mikeysklar/eink-audio-player/docs/media/anatomy/eink-audio-player.gif

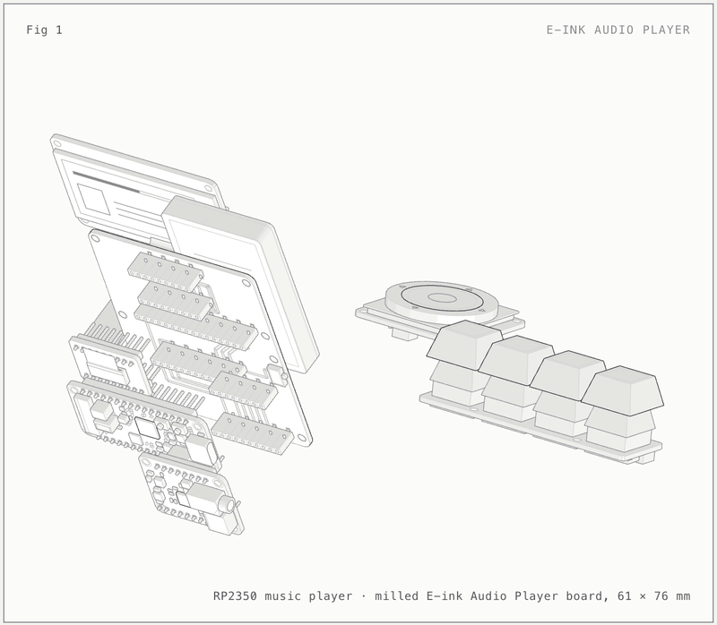
docs/media/anatomy/eink-audio-player.gif
