mikeysklar/eink-audio-player/docs/media/blender/board-hero.png

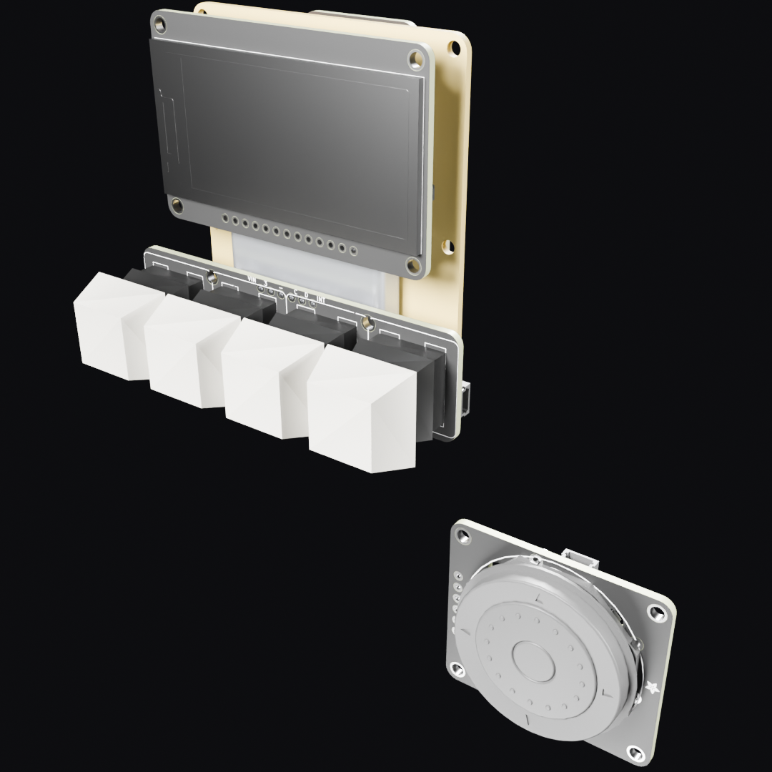
docs/media/blender/board-hero.png
