mikeysklar/eink-audio-player/docs/media/blender/exploded.png

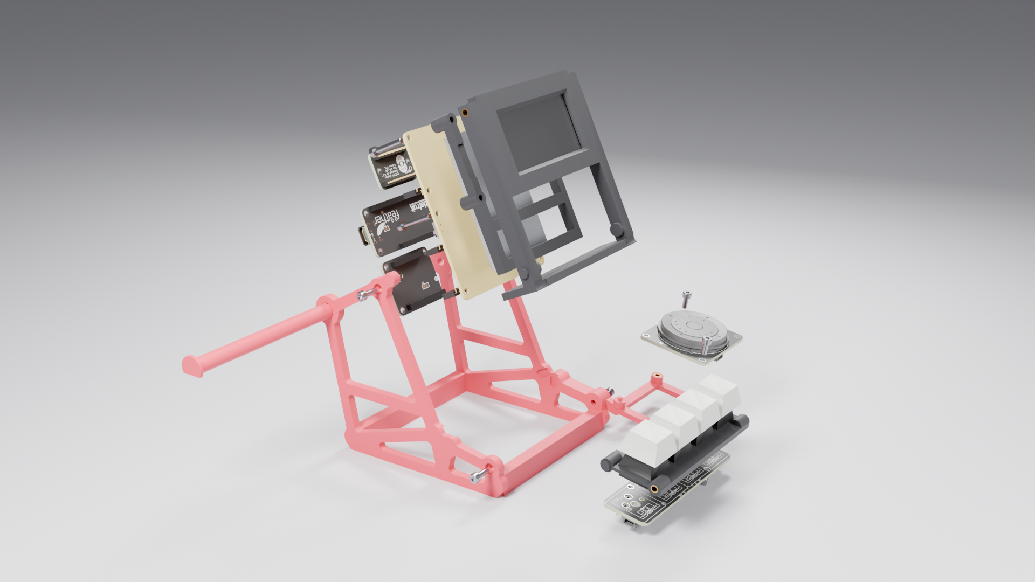
docs/media/blender/exploded.png
