mikeysklar/eink-audio-player/docs/media/blender/hero.png

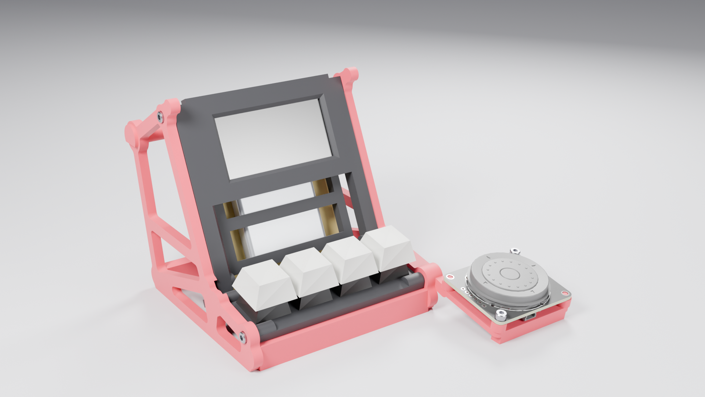
docs/media/blender/hero.png
