mikeysklar/eink-audio-player/docs/media/kicad/pcb-3d-top.png

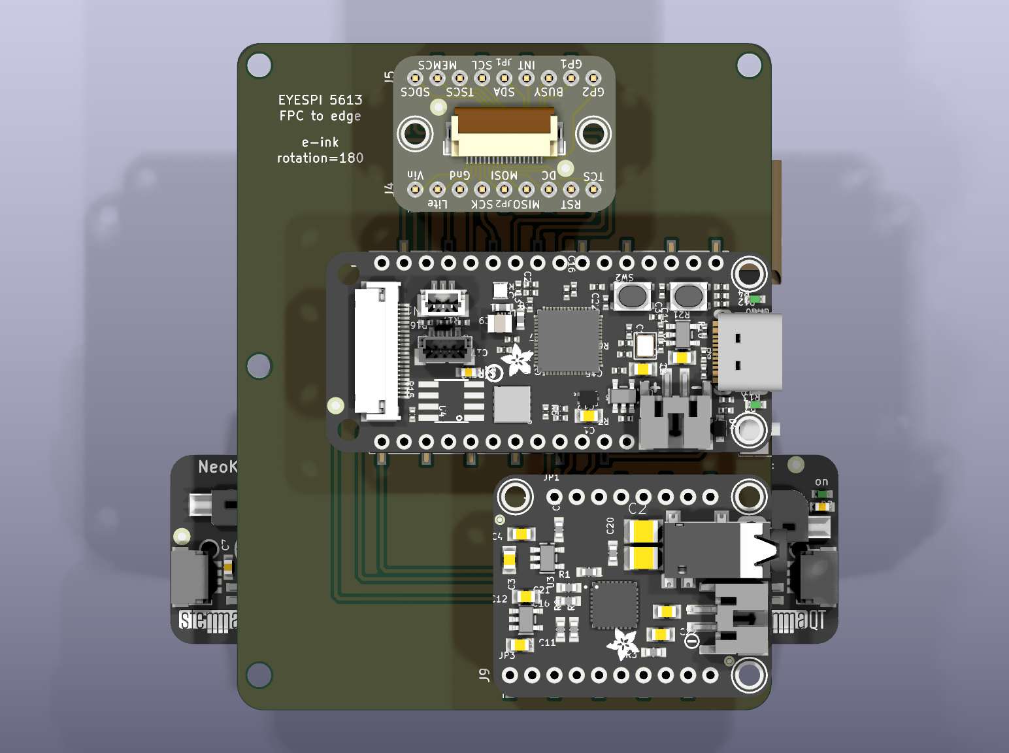
docs/media/kicad/pcb-3d-top.png
