mikeysklar/eink-audio-player/docs/media/menus/1-albums.png

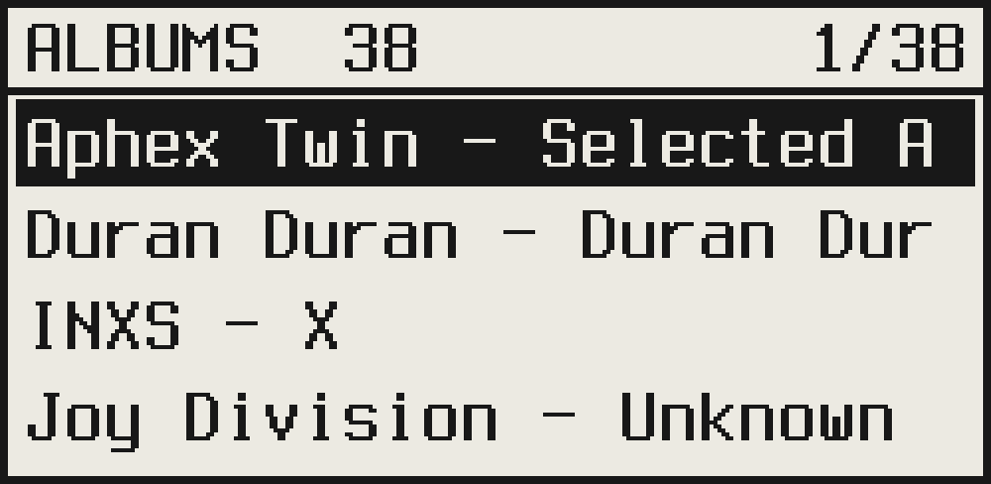
docs/media/menus/1-albums.png
