mikeysklar/eink-audio-player/docs/media/menus/2-albums-scrolled.png

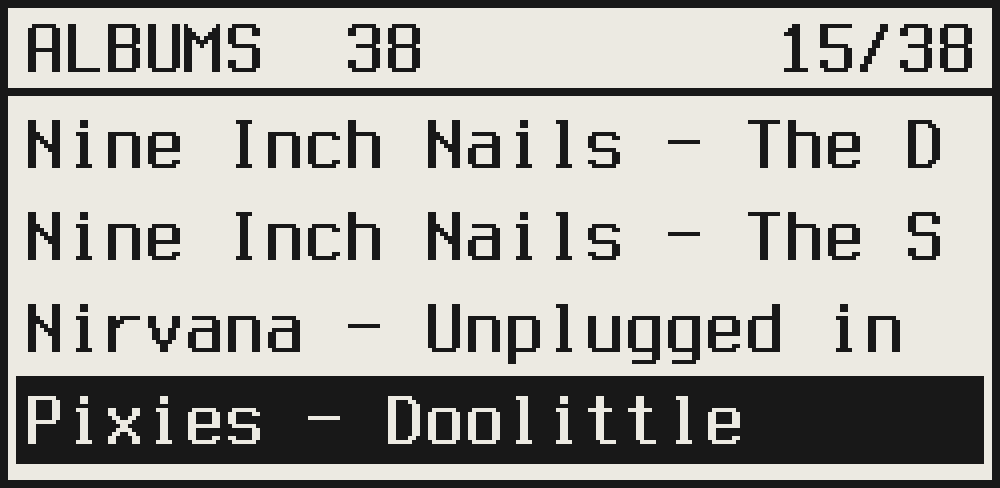
docs/media/menus/2-albums-scrolled.png
