mikeysklar/eink-audio-player/docs/media/menus/3-tracks.png

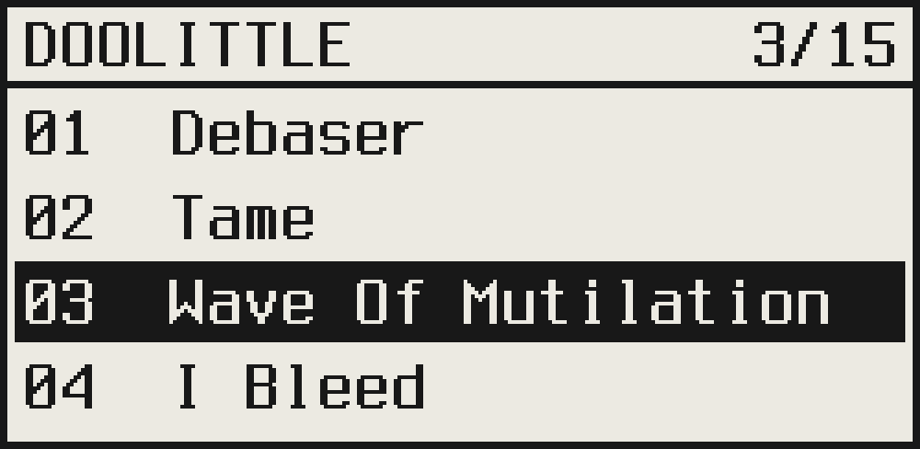
docs/media/menus/3-tracks.png
