mikeysklar/eink-audio-player/docs/media/menus/4-now-playing.png

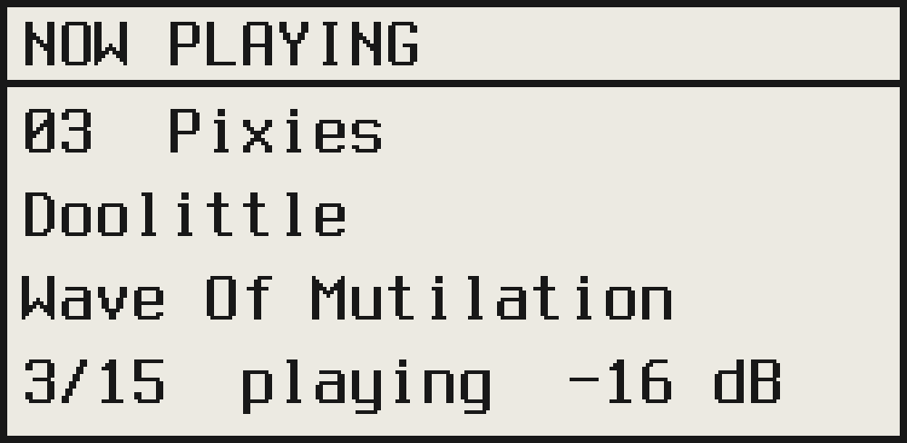
docs/media/menus/4-now-playing.png
