mikeysklar/eink-audio-player/docs/media/menus/5-now-paused.png

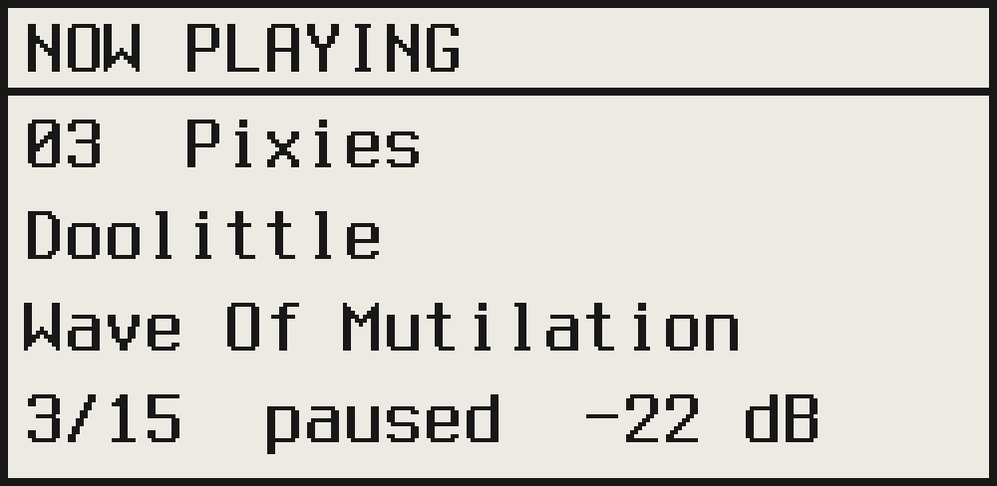
docs/media/menus/5-now-paused.png
