mikeysklar/eink-audio-player/docs/media/menus/6-search-empty.png

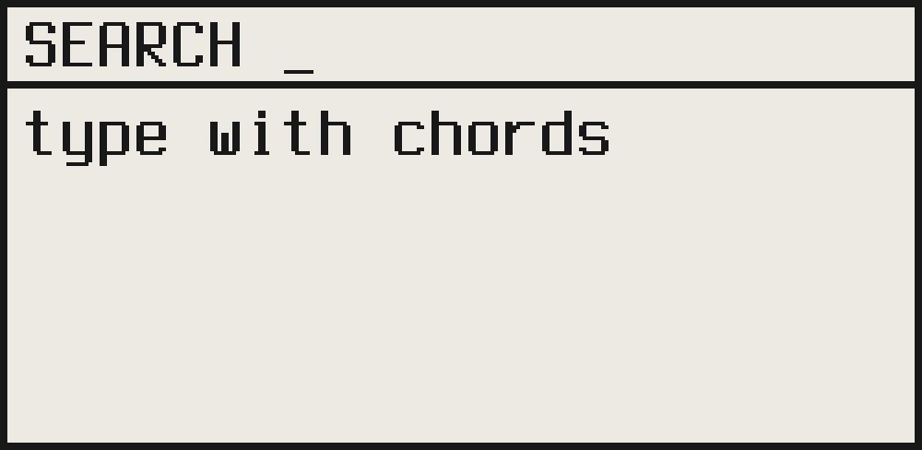
docs/media/menus/6-search-empty.png
