mikeysklar/eink-audio-player/docs/media/menus/7-search-sh.png

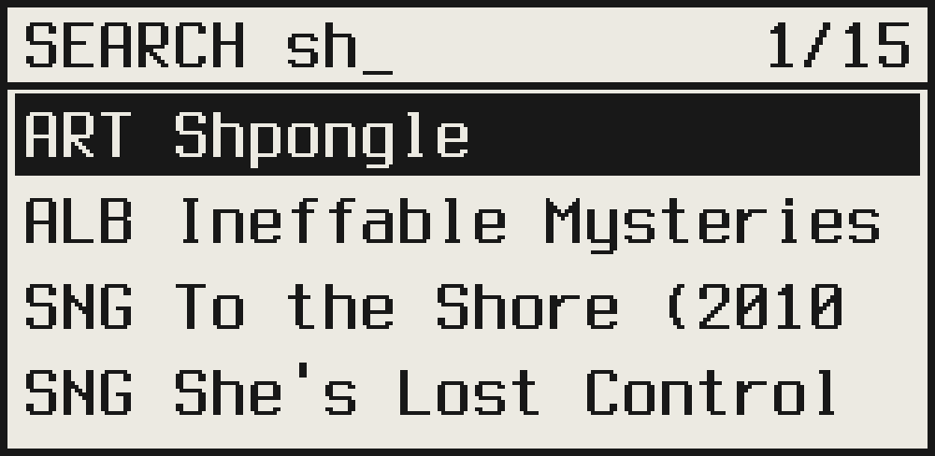
docs/media/menus/7-search-sh.png
