mikeysklar/eink-audio-player/docs/media/menus/8-search-shad.png

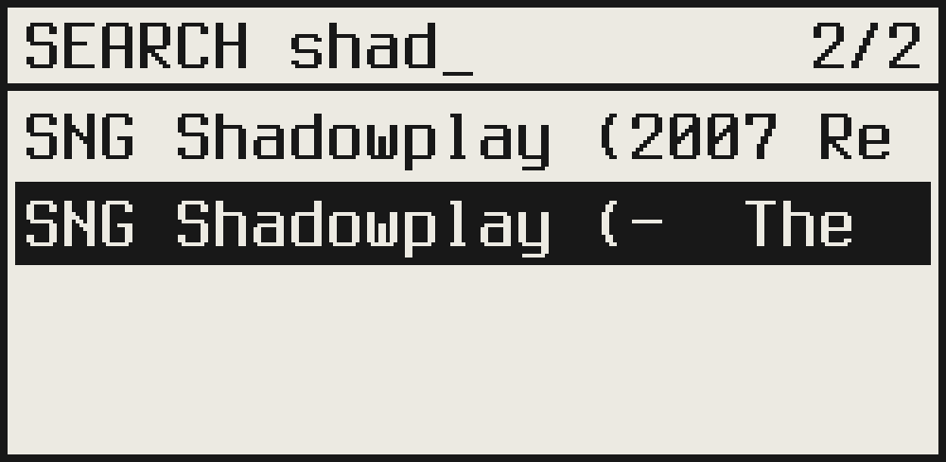
docs/media/menus/8-search-shad.png
