mikeysklar/eink-audio-player/docs/media/menus/9-search-rem.png

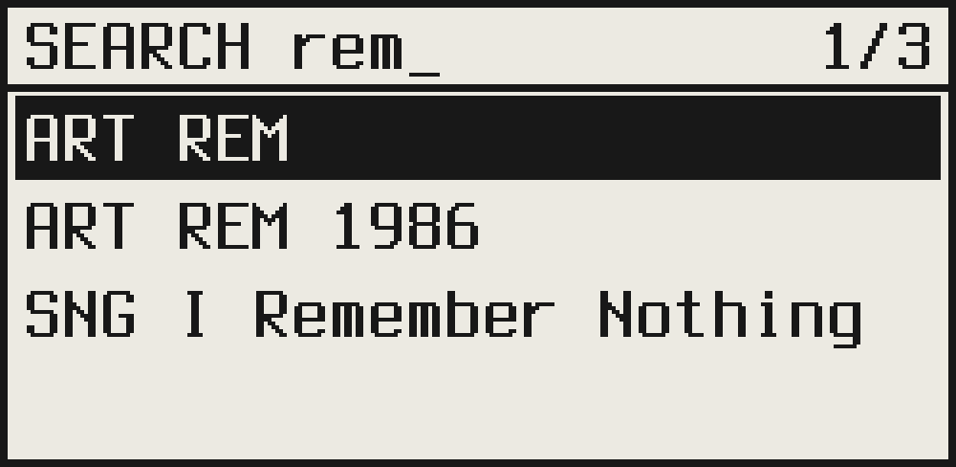
docs/media/menus/9-search-rem.png
