mikeysklar/eink-audio-player/docs/media/menus/10-artist.png

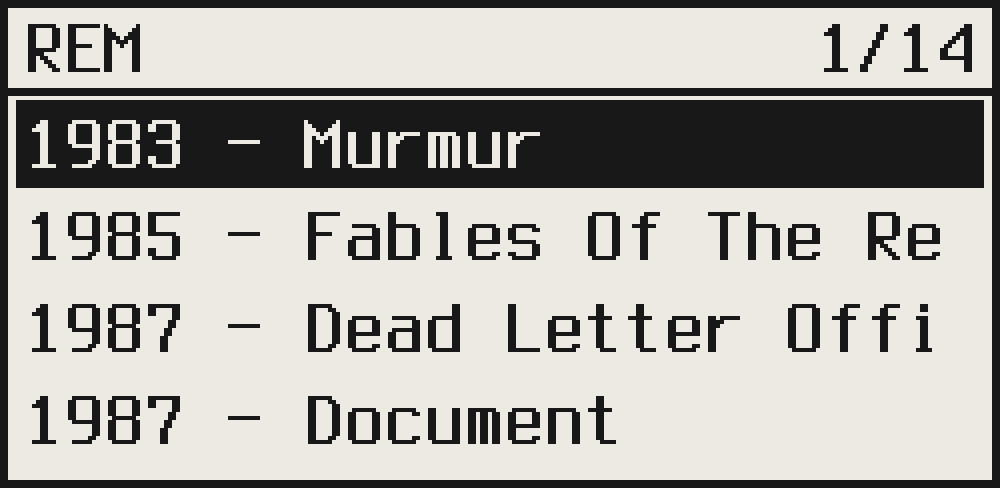
docs/media/menus/10-artist.png
