mikeysklar/eink-audio-player/enclosure/frisson.FCStd

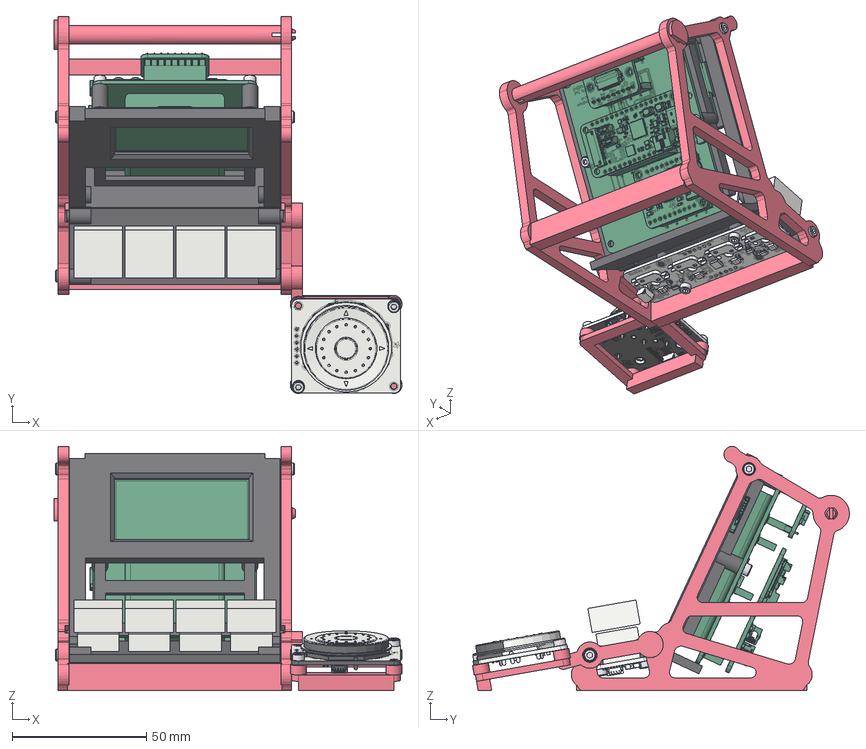
[picture p25: CAD file, 2026-10-26]
enclosure/frisson.FCStd
129.6 x 140.5 x 91.0 mm
chassis
bezel
deck
cradle
handle
board_stack
neokey_keys
ano
hardware
