mikeysklar/eink-audio-player/enclosure/step/hardware.step

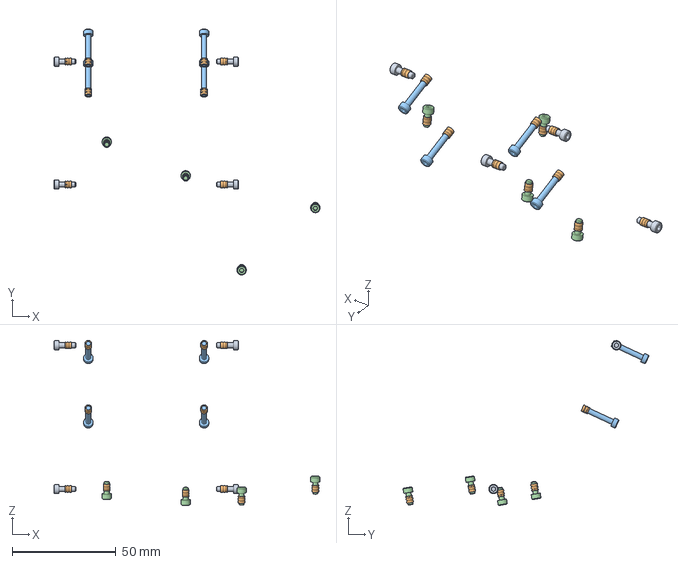
[picture p26: CAD file, 2026-10-24]
enclosure/step/hardware.step
128.3 x 118.7 x 79.7 mm
