mikeysklar/eink-audio-player/kicad/3d/5740 ANO Rotary Encoder QT.step

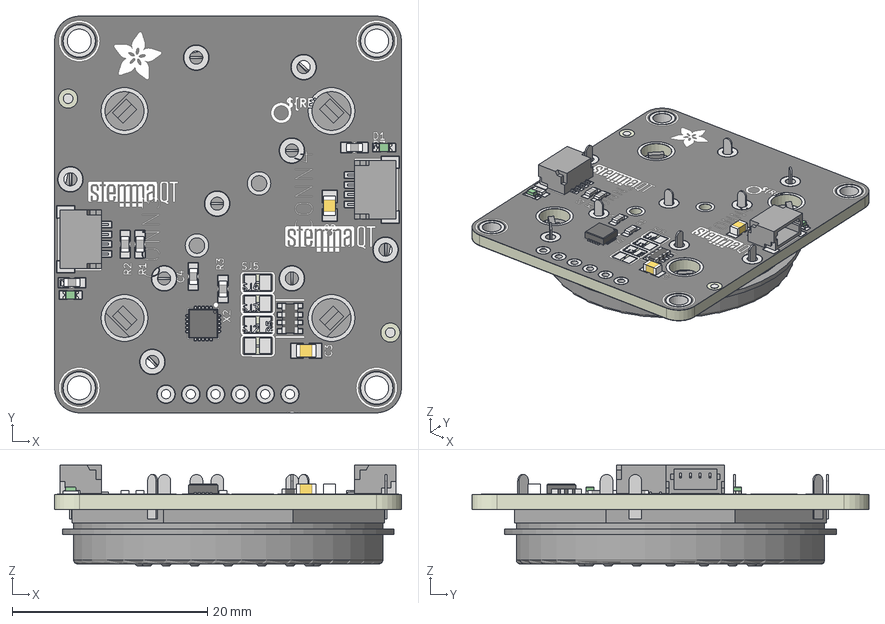
[picture p27: CAD file, 2026-10-24]
kicad/3d/5740 ANO Rotary Encoder QT.step
35.6 x 40.6 x 10.3 mm
0805-NO x 2
0603-NO x 6
JST_SH4 x 2
CHIPLED_0603_NOOUTLINE x 2
ENCODER_ANO
QFN20_3MM
RESPACK_4X0603
ano_pad
ano_silkscreen x 2
ano_soldermask x 2
ano_PCB
