mikeysklar/eink-audio-player/enclosure/step/deck.step

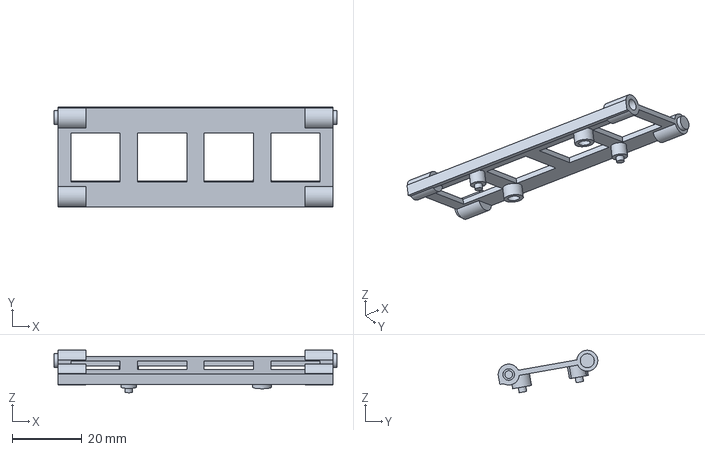
[picture p28: CAD file, 2026-10-24]
enclosure/step/deck.step
80.9 x 28.6 x 12.2 mm
