mikeysklar/eink-audio-player/kicad/3d/6366 2.13in Tri-Color eInk.step

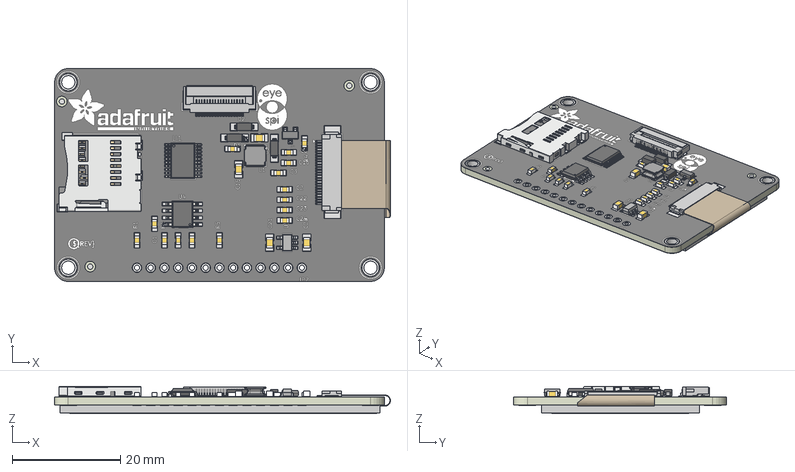
[picture p29: CAD file, 2026-10-24]
kicad/3d/6366 2.13in Tri-Color eInk.step
62.1 x 39.4 x 5.00 mm
0805-NO x 4
0603-NO x 15
SOT23-5
SOIC8_150MIL
EINK_213IN_104X212
SOD-123 x 3
INDUCTOR_4X4MM_NR401
SOT23-3
MICROSD
TSSOP20
EYE_SPI_DISPLAY_BOTCONTACT
FPC-connector-24pin v3
eink_pad
eink_silkscreen x 2
eink_soldermask x 2
eink_PCB
