mikeysklar/eink-audio-player/enclosure/step/eink-audio-player-stand.step

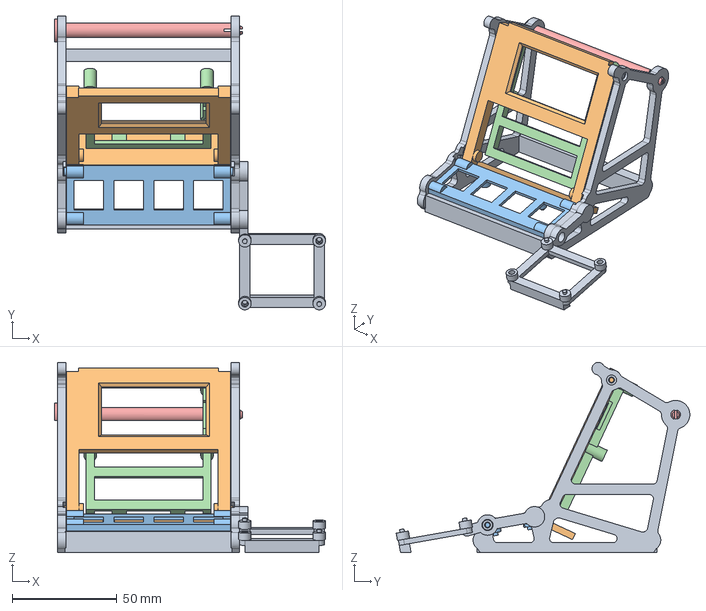
[picture p30: CAD file, 2026-10-24]
enclosure/step/eink-audio-player-stand.step
129.6 x 140.5 x 91.0 mm
