mikeysklar/eink-audio-player/kicad/3d/5613 EYESPI Breakout.step

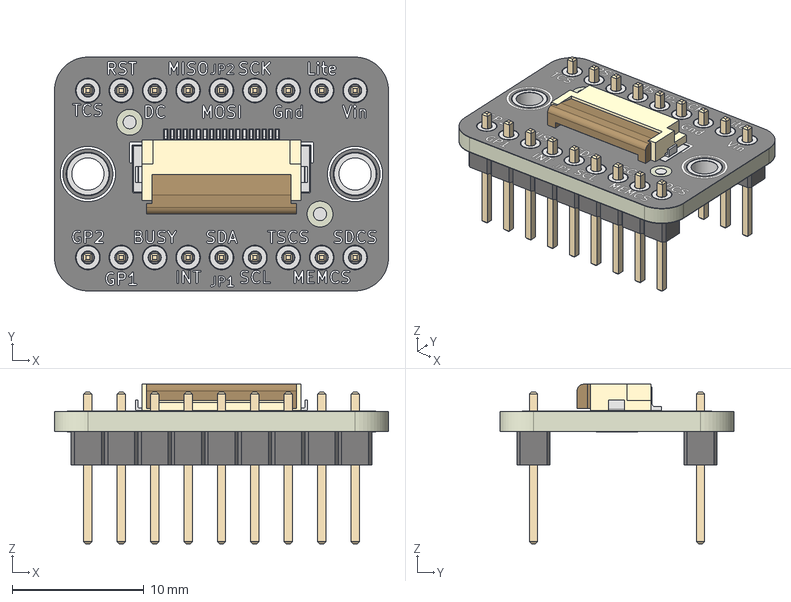
[picture p31: CAD file, 2026-10-24]
kicad/3d/5613 EYESPI Breakout.step
25.4 x 17.8 x 12.1 mm
PinHeader_1x09_P254mm_Vertical x 2
lock
pins
eyespi_copper
eyespi_pad
eyespi_silkscreen x 2
eyespi_soldermask x 2
eyespi_PCB
