mikeysklar/eink-audio-player/enclosure/step/chassis.step

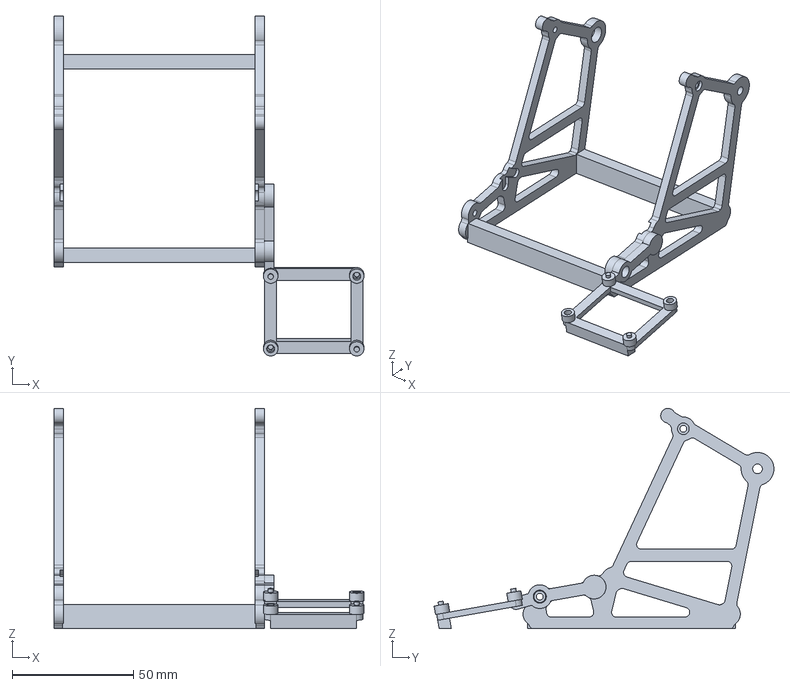
[picture p32: CAD file, 2026-10-24]
enclosure/step/chassis.step
128.1 x 140.5 x 91.0 mm
