mikeysklar/eink-audio-player/kicad/3d/4980 NeoKey 1x4 QT.step

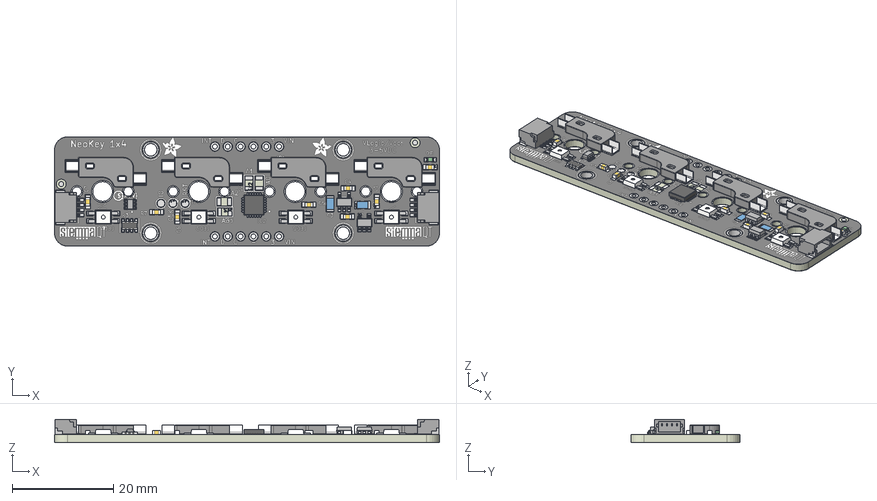
[picture p33: CAD file, 2026-10-24]
kicad/3d/4980 NeoKey 1x4 QT.step
76.2 x 21.6 x 4.61 mm
KAILH_SOCKET x 4
NEO3535_REVERSE x 4
0603-NO x 8
0805-NO x 2
SOT23-5
RESPACK_4X0603
SOT363
JST_SH4 x 2
CHIPLED_0603_NOOUTLINE
QFN24_4MM
SOT23-5 (1)
neokey_pad
neokey_silkscreen x 2
neokey_soldermask x 2
neokey_PCB
