mikeysklar/eink-audio-player/enclosure/step/bezel.step

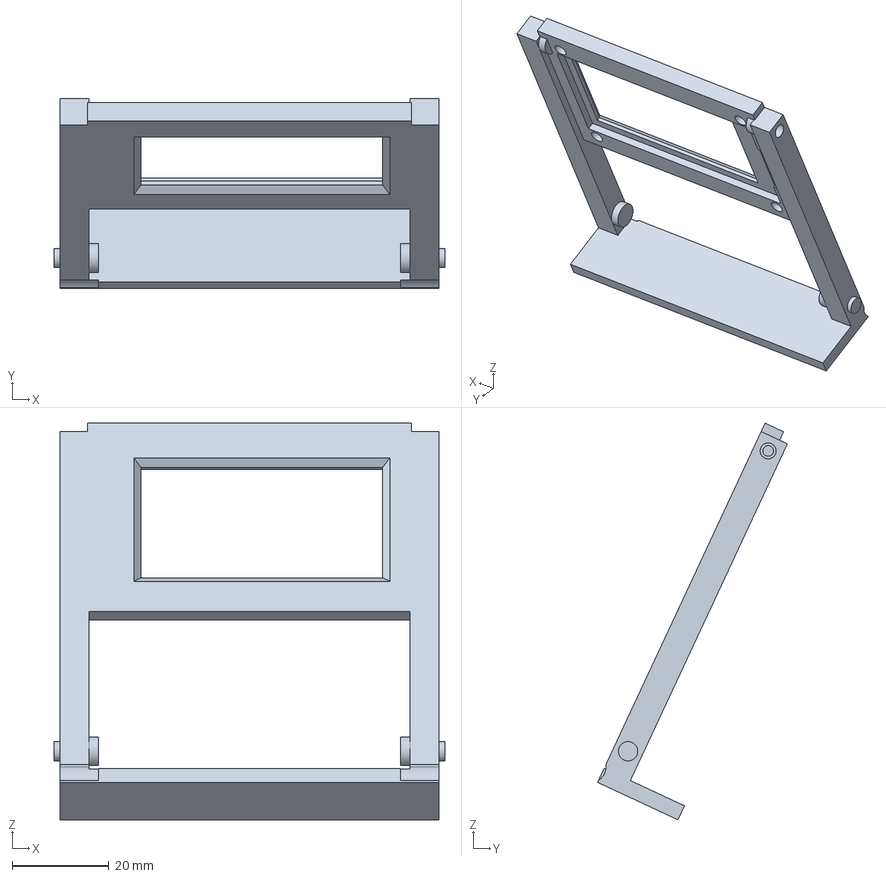
[picture p34: CAD file, 2026-10-24]
enclosure/step/bezel.step
80.9 x 39.3 x 82.1 mm
