mikeysklar/eink-audio-player/kicad/3d/6309 TLV320DAC3100 I2S DAC.step

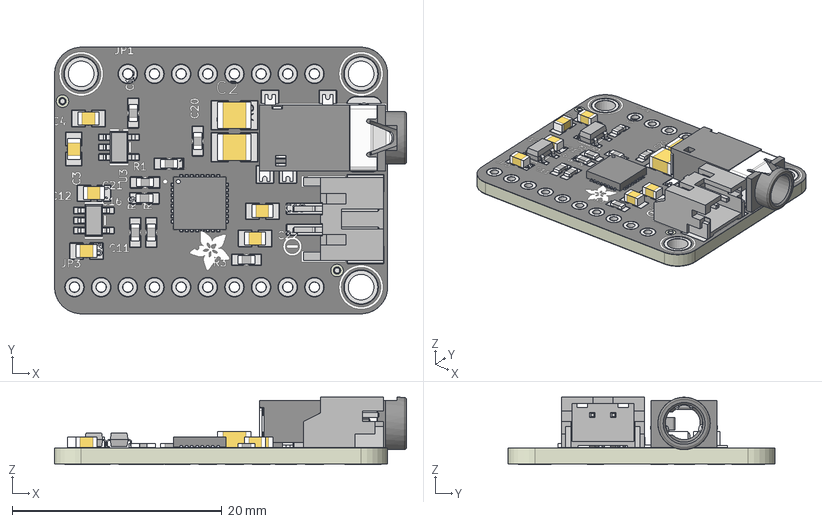
[picture p35: CAD file, 2026-10-24]
kicad/3d/6309 TLV320DAC3100 I2S DAC.step
33.5 x 25.4 x 6.45 mm
SOT23-5 x 2
0805-NO x 6
0603-NO x 8
PJ-332A
TLV320DAC3100
C1210 x 2
JSTPH2
tlv_pad
tlv_silkscreen x 2
tlv_soldermask x 2
tlv_PCB
