mikeysklar/eink-audio-player/enclosure/step/cradle.step

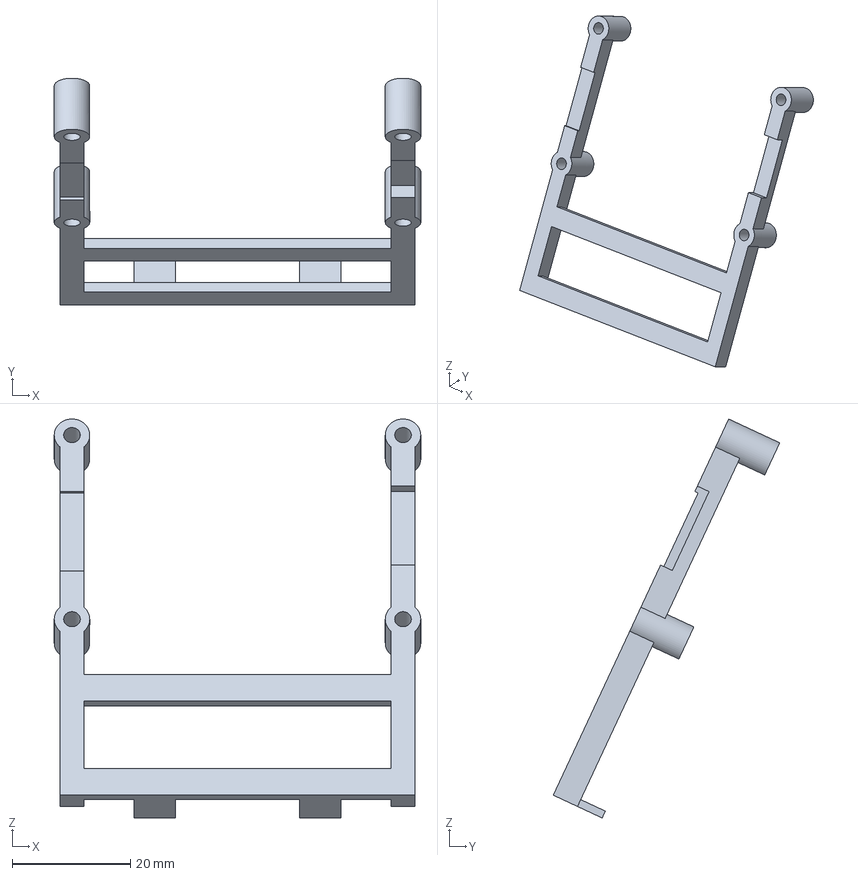
[picture p36: CAD file, 2026-10-24]
enclosure/step/cradle.step
61.9 x 38.2 x 67.4 mm
