mikeysklar/eink-audio-player/kicad/3d/6000 Feather RP2350.step

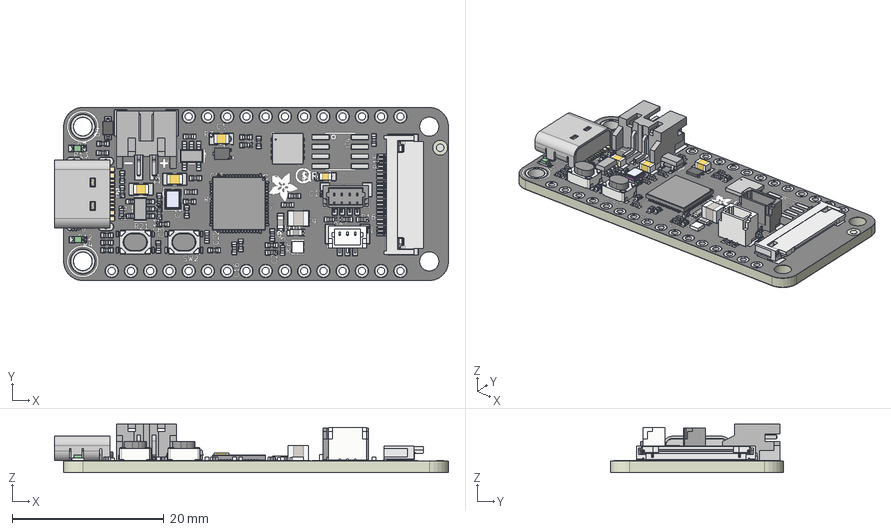
[picture p37: CAD file, 2026-10-24]
kicad/3d/6000 Feather RP2350.step
52.0 x 22.9 x 6.45 mm
0805-NO x 3
CHIPLED_0603_NOOUTLINE x 2
_0402NO x 34
BTN_RKB2_4.6X2.8 x 2
SOT23-5
JSTPH2_BATT
SOT23-5 (1)
0603-NO
SK6805_1515
USON8_4X4
SOD-323F
DFN2015-3
USB_C_CUSB31-CFM2AX-01-X
CRYSTAL_2.5X2
_0603MP x 2
QFN60_7MM_REDUCEDEPAD
INDUCTOR_1007
FPC_22PIN
JST_SH4_RA
JST_SH3_RA
feather_pad
feather_silkscreen x 2
feather_soldermask x 2
feather_PCB
