mikeysklar/eink-audio-player/enclosure/step/handle.step

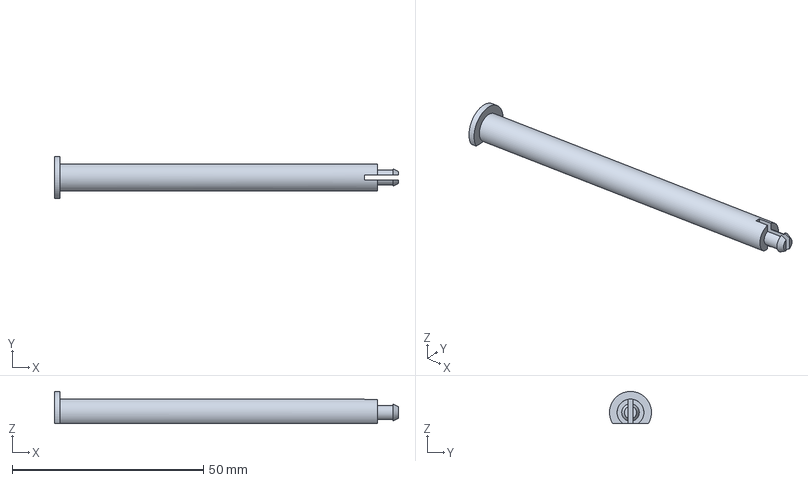
[picture p38: CAD file, 2026-10-24]
enclosure/step/handle.step
90.0 x 11.0 x 8.40 mm
