mikeysklar/eink-audio-player/kicad/3d/LiPo 2750 PLACEHOLDER.step

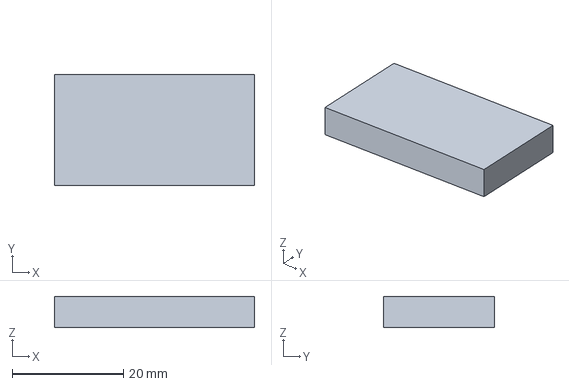
[picture p39: CAD file, 2026-10-23]
kicad/3d/LiPo 2750 PLACEHOLDER.step
36.0 x 20.0 x 5.60 mm
