mikeysklar/eink-audio-player/enclosure/step/ano_mount.step

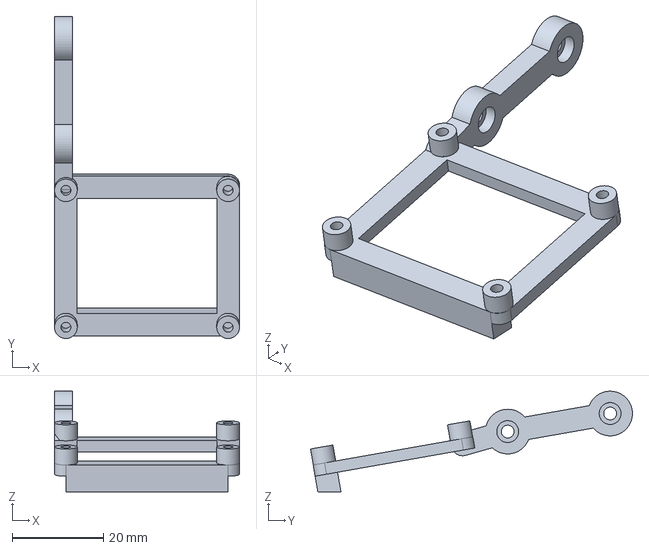
[picture p40: CAD file, 2026-10-24]
enclosure/step/ano_mount.step
40.6 x 70.6 x 22.1 mm
