mikeysklar/eink-audio-player/kicad/3d/LiPo 258 PLACEHOLDER.step

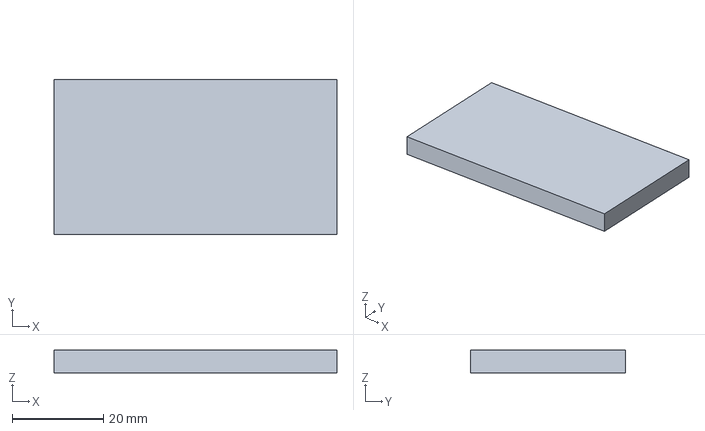
[picture p41: CAD file, 2026-10-23]
kicad/3d/LiPo 258 PLACEHOLDER.step
62.0 x 34.0 x 5.00 mm
