mikeysklar/eink-audio-player/enclosure/step/brace_front.step

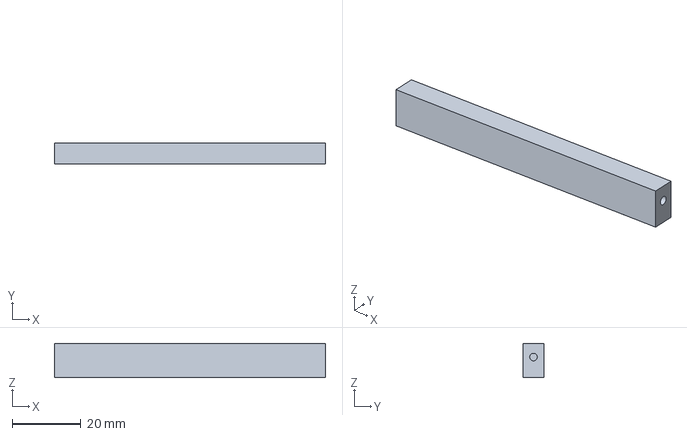
[picture p42: CAD file, 2026-10-23]
enclosure/step/brace_front.step
79.0 x 6.00 x 10.0 mm
