mikeysklar/eink-audio-player/kicad/3d/LiPo 1578 PLACEHOLDER.step

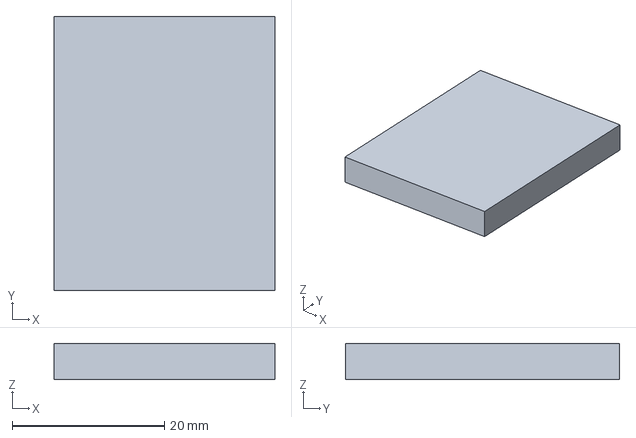
[picture p43: CAD file, 2026-10-23]
kicad/3d/LiPo 1578 PLACEHOLDER.step
29.0 x 36.0 x 4.75 mm
