mikeysklar/eink-audio-player/enclosure/step/cheek_L.step

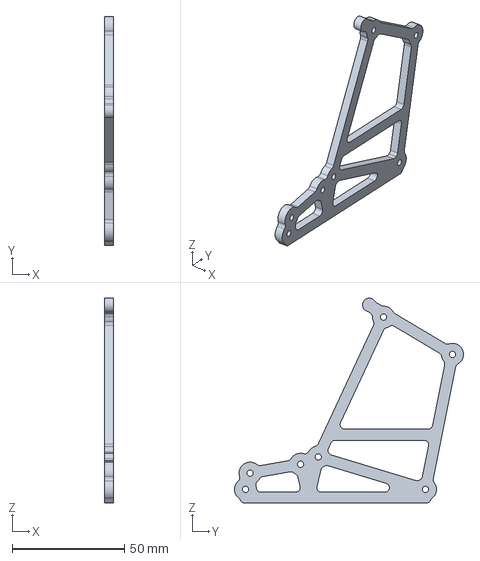
[picture p44: CAD file, 2026-10-23]
enclosure/step/cheek_L.step
4.00 x 101.8 x 91.0 mm
