mikeysklar/eink-audio-player/kicad/3d/slide-switch-smt-mskt-12c03-Part.step

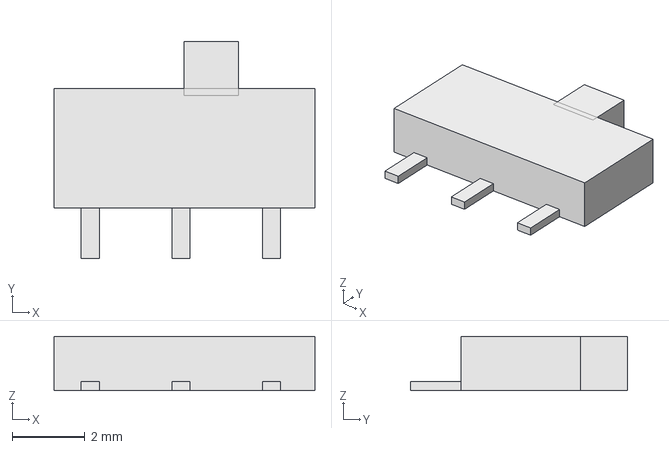
[picture p45: CAD file, 2026-10-23]
kicad/3d/slide-switch-smt-mskt-12c03-Part.step
7.20 x 6.00 x 1.50 mm
