mikeysklar/eink-audio-player/enclosure/step/battery_strap.step

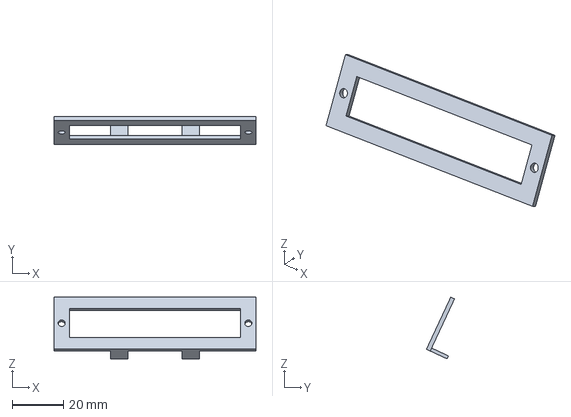
[picture p46: CAD file, 2026-10-23]
enclosure/step/battery_strap.step
79.0 x 11.0 x 24.2 mm
