mikeysklar/eink-audio-player/kicad/3d/4197 eInk 2.13 PLACEHOLDER.step

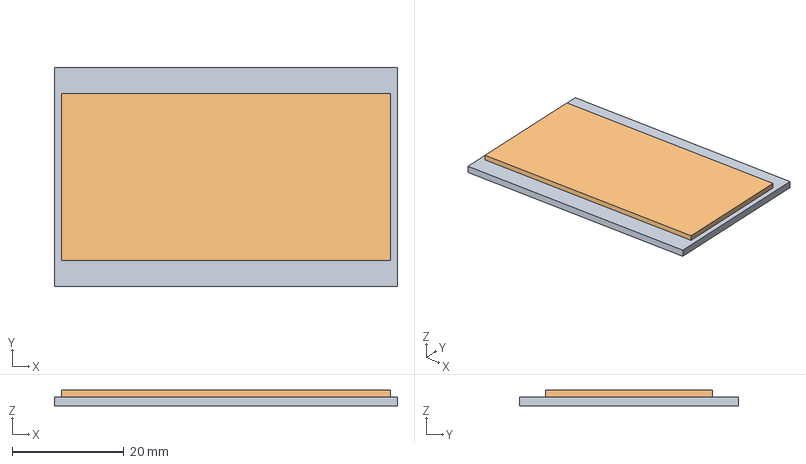
[picture p47: CAD file, 2026-10-23]
kicad/3d/4197 eInk 2.13 PLACEHOLDER.step
61.5 x 39.3 x 2.80 mm
