mikeysklar/eink-audio-player/kicad/3d/LiPo 3898 PLACEHOLDER.step

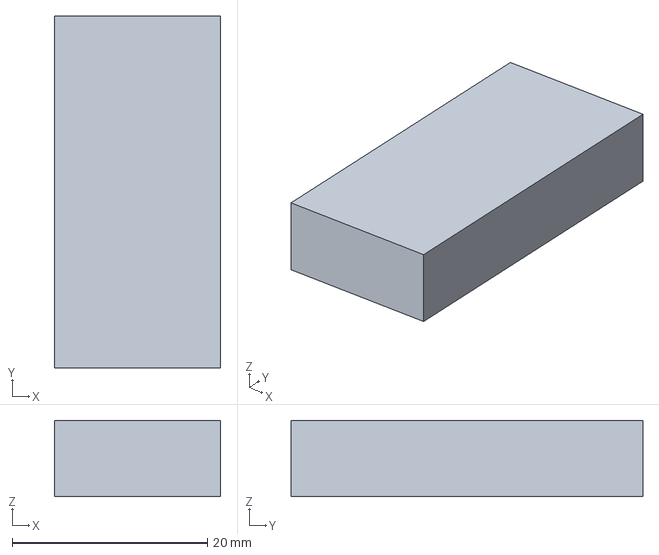
[picture p48: CAD file, 2026-10-23]
kicad/3d/LiPo 3898 PLACEHOLDER.step
17.0 x 36.0 x 7.80 mm
