mikeysklar/eink-audio-player/enclosure/step/brace_top.step

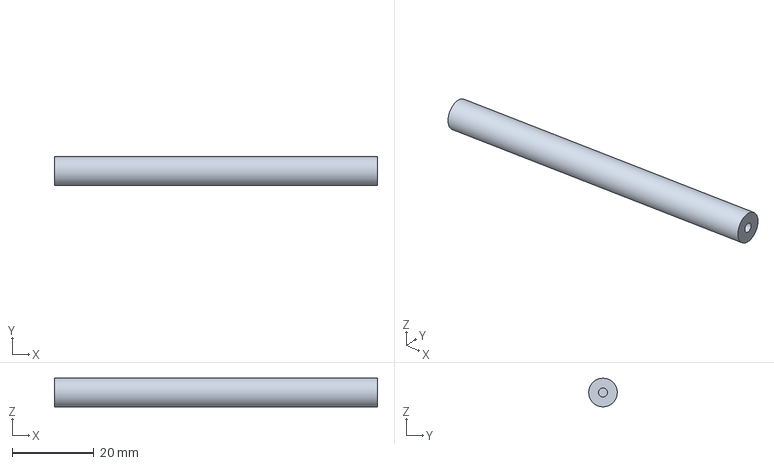
[picture p49: CAD file, 2026-10-23]
enclosure/step/brace_top.step
79.0 x 7.00 x 6.99 mm
