mikeysklar/eink-audio-player/kicad/3d/1028 eInk 2.9 tri-color STAND-IN.step

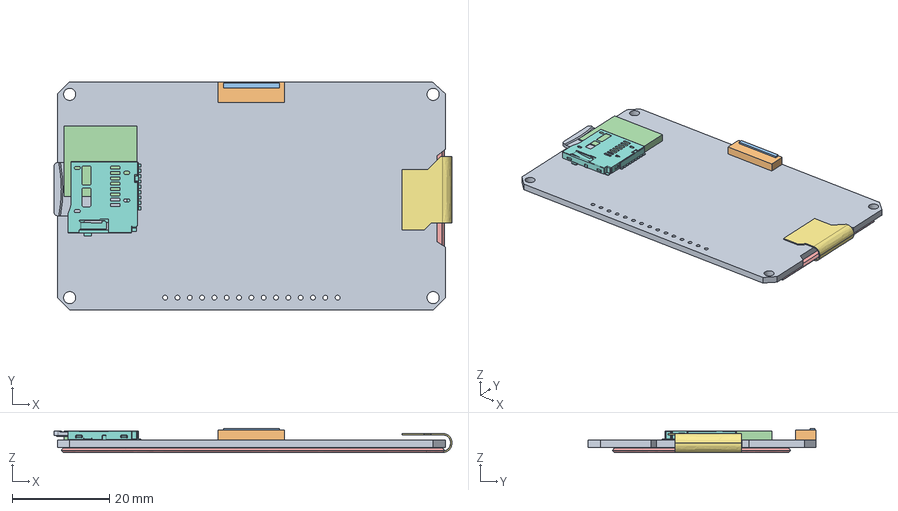
[picture p50: CAD file, 2026-10-23]
kicad/3d/1028 eInk 2.9 tri-color STAND-IN.step
82.1 x 47.0 x 5.05 mm
pcb
eyespi_fpc
eyespi_latch
microsd
s62
s61
s60
s7
s6
