mikeysklar/eink-audio-player/kicad/3d/Hanbo TF-027-H375 PLACEHOLDER.step

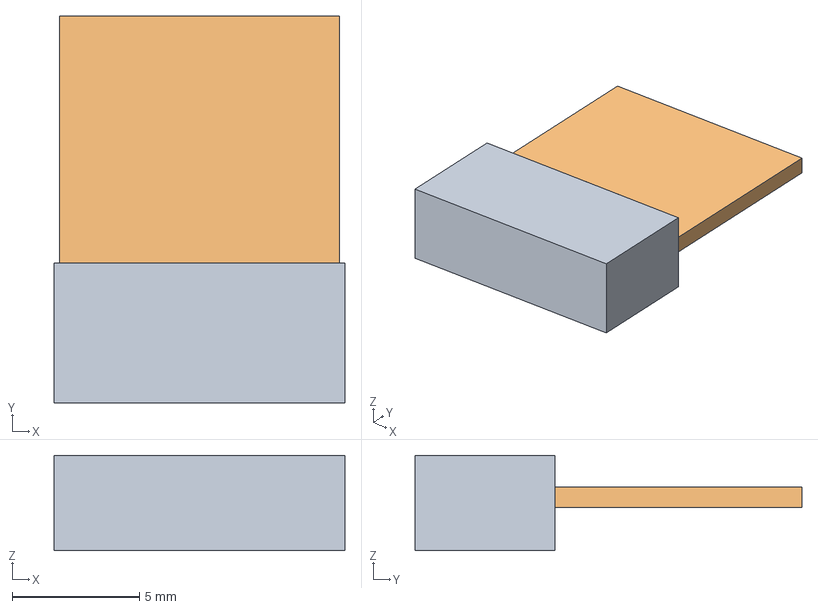
[picture p51: CAD file, 2026-10-23]
kicad/3d/Hanbo TF-027-H375 PLACEHOLDER.step
11.4 x 15.2 x 3.75 mm
