mikeysklar/eink-audio-player/(list of files, cad)

Other CAD files:
enclosure/inputs/board.step
enclosure/eink-audio-player.FCStd
enclosure/step/brace_rear.step
enclosure/step/cheek_R.step
blender/explode.blend
blender/turntable.blend
enclosure/stl/ano_mount.stl
enclosure/stl/battery_strap.stl
enclosure/stl/bezel.stl
enclosure/stl/brace_front.stl
enclosure/stl/brace_rear.stl
enclosure/stl/brace_top.stl
enclosure/stl/chassis.stl
enclosure/stl/cheek_L.stl
enclosure/stl/cheek_R.stl
enclosure/stl/cradle.stl
enclosure/stl/deck.stl
enclosure/stl/handle.stl
