mikeysklar/eink-audio-player/docs/media/enclosure/assembly.png

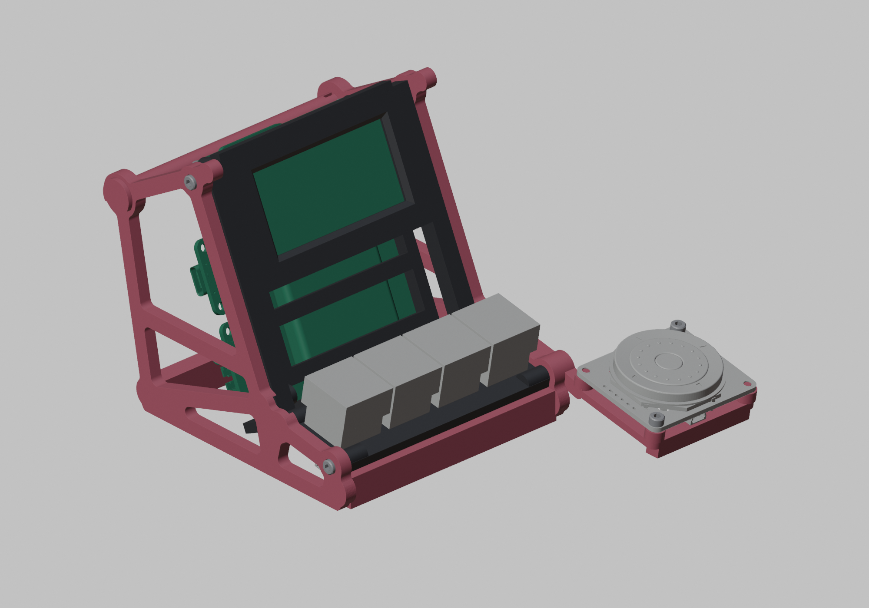
docs/media/enclosure/assembly.png
