mikeysklar/eink-audio-player/docs/media/video/assembly.jpg

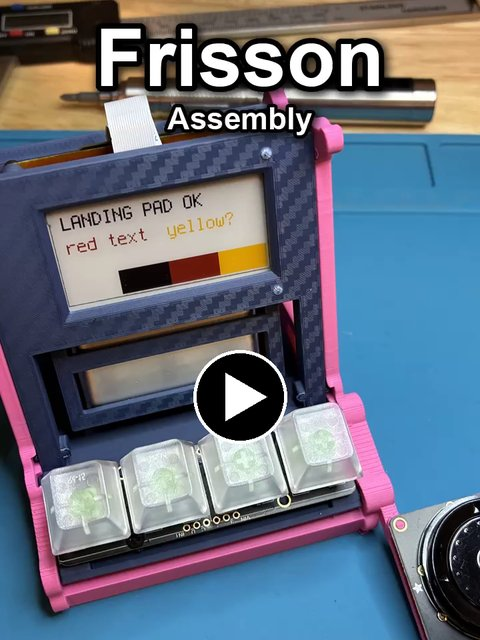
docs/media/video/assembly.jpg
