mikeysklar/eink-audio-player/docs/media/video/fabrication.jpg

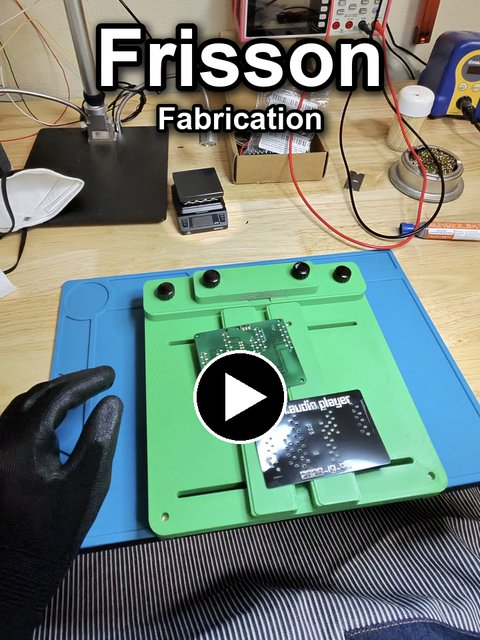
docs/media/video/fabrication.jpg
