mikeysklar/eink-audio-player/kicad/frisson.kicad_pcb

## KiCad design kicad/frisson.kicad_pcb (2026-10-26)

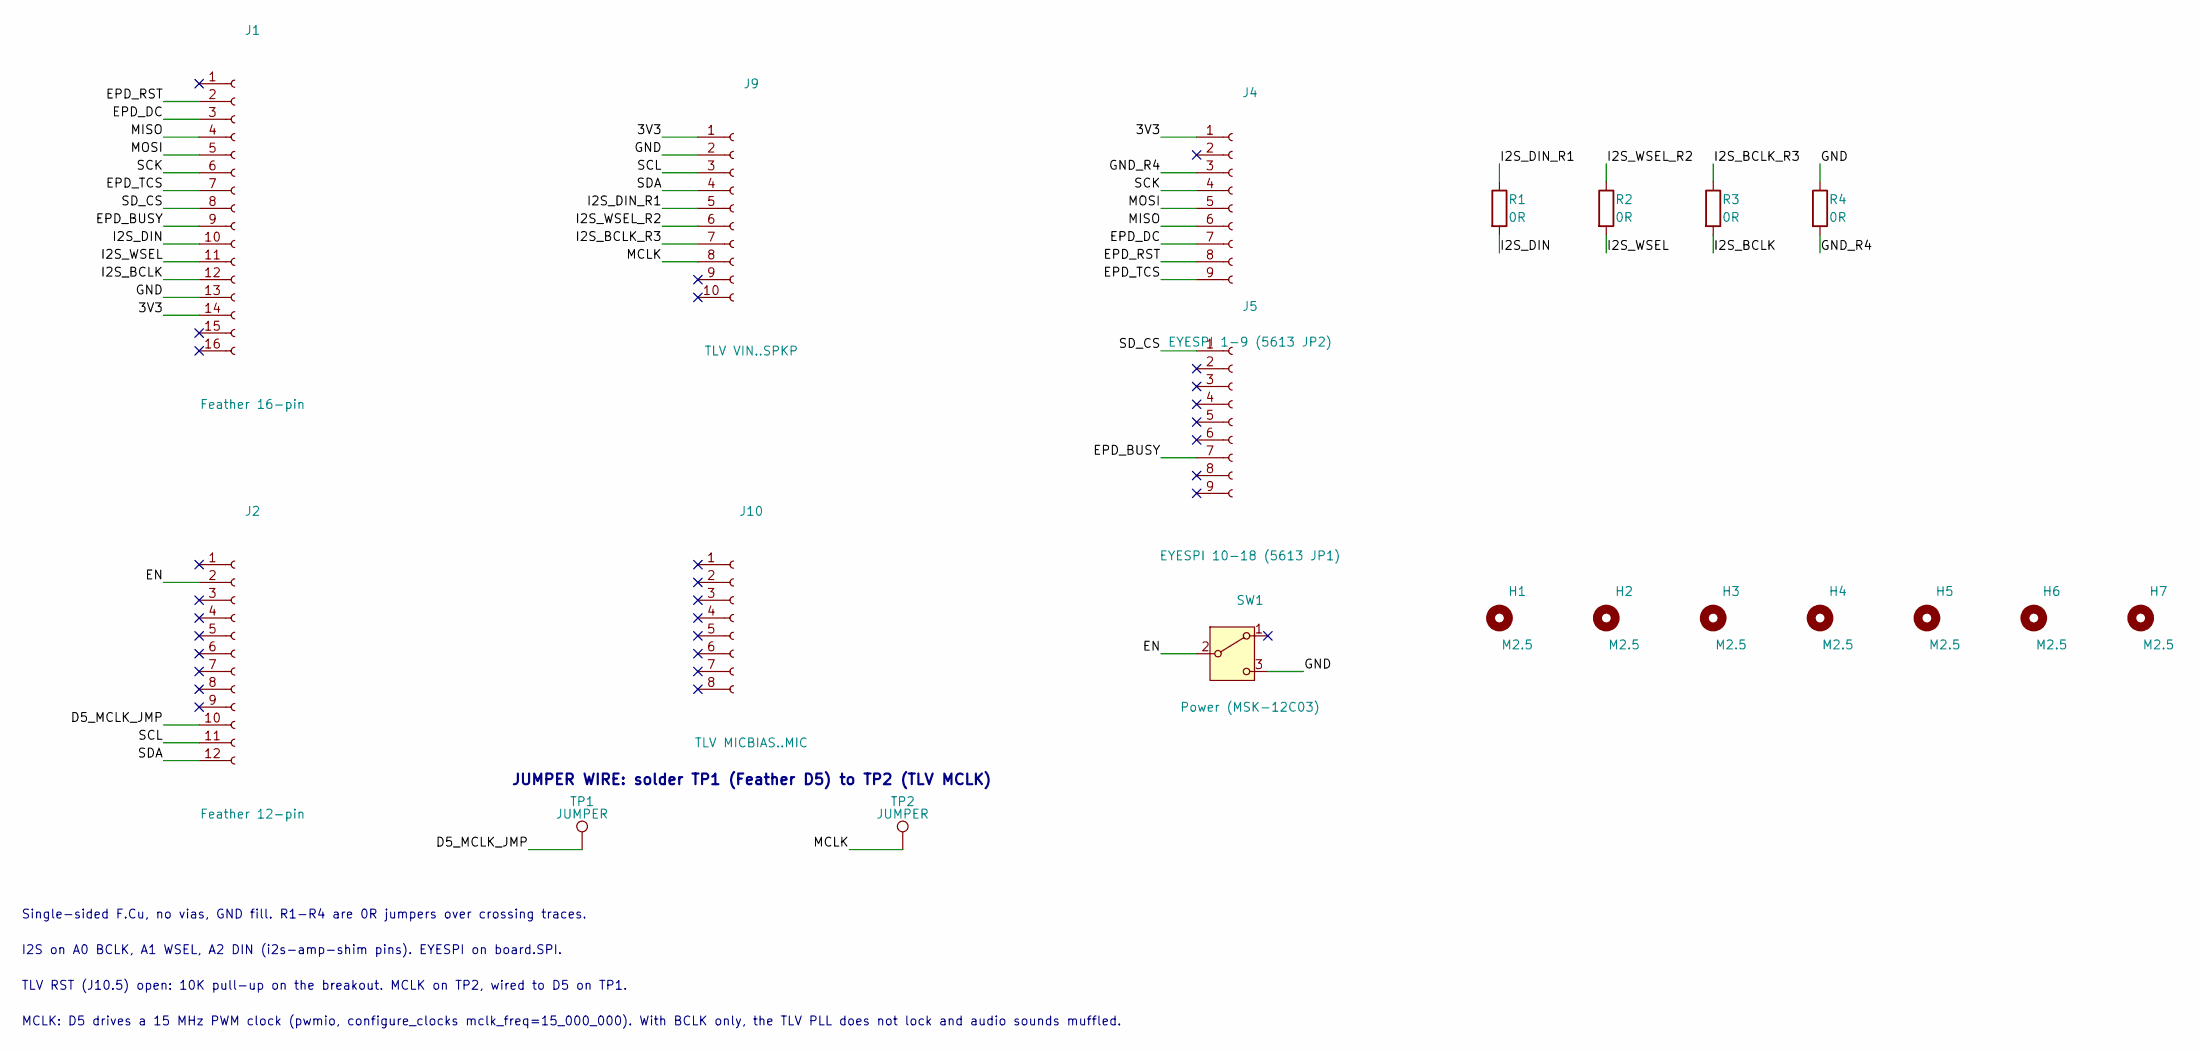
[picture p55: schematic frisson.kicad_sch]

Parts:
H1, H2, H3, H4, H5, H6, H7: M2.5; MountingHole_2.7mm
J1: Feather 16-pin; PinSocket_1x16_P2.54mm_Vertical_SMD_Pin1Left
J2: Feather 12-pin; PinSocket_1x12_P2.54mm_Vertical_SMD_Pin1Left
J4: EYESPI 1-9 (5613 JP2); PinSocket_1x09_P2.54mm_Vertical_SMD_Pin1Left
J5: EYESPI 10-18 (5613 JP1); PinSocket_1x09_P2.54mm_Vertical_SMD_Pin1Left
J9: TLV VIN..SPKP; PinSocket_1x10_P2.54mm_Vertical_SMD_Pin1Left
J10: TLV MICBIAS..MIC; PinSocket_1x08_P2.54mm_Vertical_SMD_Pin1Left
R1, R2, R3, R4: 0R; R_0805_2012Metric
SW1: Power (MSK-12C03); SW_SPDT_MSK-12C03
TP1, TP2: JUMPER; JumperPad_3.8x2.0mm

Connections:
/3V3: J1.14, J4.1, J9.1
/D5_MCLK_JMP: J2.10, TP1.1
/EN: J2.2, SW1.2 (B)
/EPD_BUSY: J1.9, J5.7
/EPD_DC: J1.3, J4.7
/EPD_RST: J1.2, J4.8
/EPD_TCS: J1.7, J4.9
/GND: J1.13, J9.2, R4.1, SW1.3 (C)
/GND_R4: J4.3, R4.2
/I2S_BCLK: J1.12, R3.2
/I2S_BCLK_R3: J9.7, R3.1
/I2S_DIN: J1.10, R1.2
/I2S_DIN_R1: J9.5, R1.1
/I2S_WSEL: J1.11, R2.2
/I2S_WSEL_R2: J9.6, R2.1
/MCLK: J9.8, TP2.1
/MISO: J1.4, J4.6
/MOSI: J1.5, J4.5
/SCK: J1.6, J4.4
/SCL: J2.11, J9.3
/SDA: J2.12, J9.4
/SD_CS: J1.8, J5.1

Notes on the sheet:
Single-sided F.Cu, no vias, GND fill. R1-R4 are 0R jumpers over crossing traces.
I2S on A0 BCLK, A1 WSEL, A2 DIN (i2s-amp-shim pins). EYESPI on board.SPI.
TLV RST (J10.5) open: 10K pull-up on the breakout. MCLK on TP2, wired to D5 on TP1.
JUMPER WIRE: solder TP1 (Feather D5) to TP2 (TLV MCLK)
MCLK: D5 drives a 15 MHz PWM clock (pwmio, configure_clocks mclk_freq=15_000_000). With BCLK only, the TLV PLL does not lock and audio sounds muffled.

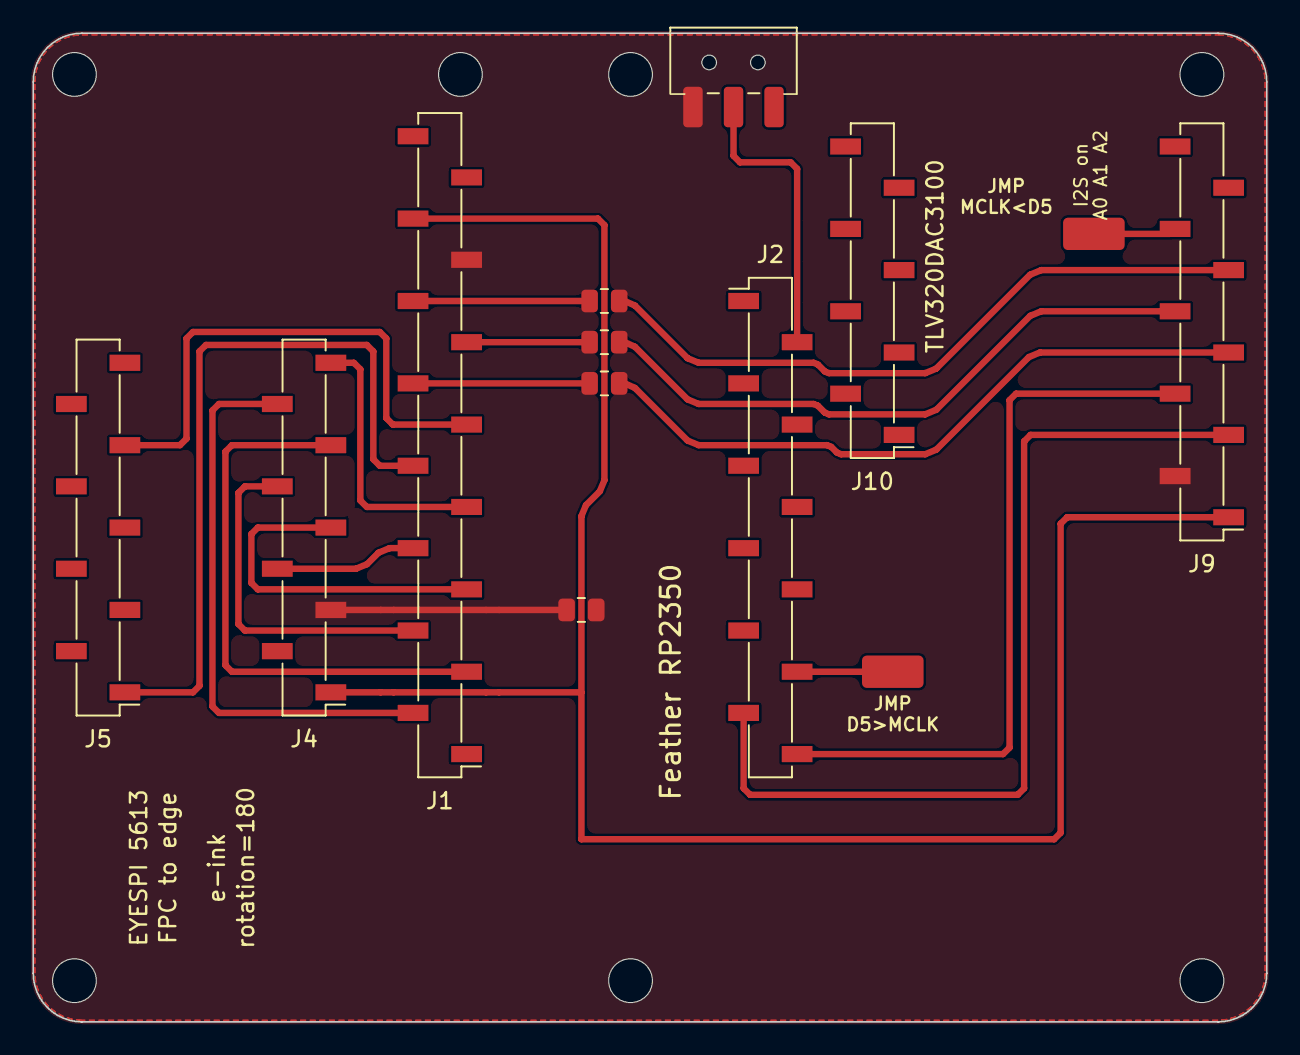
[picture p56: board frisson.kicad_pcb from above]

Board: 2 copper layers, 76.1 x 61.0 mm, 27 parts (4 on the bottom side), 22 nets.

Other parts of the board:
A1: Feather RP2350 (6000)
A3: TLV320DAC3100 breakout (6309)
A5: NeoKey 1x4 QT (4980), case-mounted
A7: EYESPI breakout (5613)
ANO1: ANO rotary encoder (6310), stand-mounted, referen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
BT1: LiPo 2000 mAh (Adafruit 2011)
DS1: 2.13in quad-colour e-ink (Adafruit 6366)
