mikeysklar/eink-audio-player/(commit log)

2026-10-23 E-ink audio player: KiCad board, mini arcade stand, renders and docs
2026-10-24 Board turntable: re-render with Cycles on the Metal GPU
2026-10-24 High-detail Adafruit board models, ANO thumb encoder and its stand mount
    Board models are Adafruit's CAD parts on Adafruit's own Eagle boards imported
    into KiCad (black mask, silkscreen, ENIG pads); kicad/3d/adafruit-hq rebuilds
    them. The ANO rotary encoder (6310) sits on a new printed ano_mount past the
    right end of the keys, and in the KiCad design as a reference part. Renders,
    anatomy and docs regenerated.
2026-10-24 Stand: five parts, 12 screws into heat inserts
    The cheeks, foot bars and ANO mount are now one printed chassis. The bezel
    slides in and the deck drops in, each located by pegs in cheek slots and held
    by two M2.5 x 8. A printed cradle replaces the brass standoffs and battery
    strap, clamped by four M2.5 x 16 into the bezel. The handle snaps in. The
    checker now clashes every screw and insert and sweeps each part along its way
    in. Renders show the hardware and take the stand apart in assembly order.
2026-10-24 Insert holes 3.3 x 3.3 mm; anatomy posed as on the stand
    Heat-insert holes now match the inserts, 3.3 mm across and 3.3 mm deep, with
    the NeoKey standoffs grown to 5.5 mm and the screw-tip holes lengthened.
    The anatomy figure now sits in the stand's pose from layout.json, seen from
    behind: the board at 65 degrees, the keys and ANO in front at 10 degrees,
    sliding out together when it comes apart.
2026-10-24 Re-render Blender stills and videos with 3.3 mm insert holes
2026-10-24 Rotate the board 90 degrees to landscape (76 x 61 mm)
    Drawing only; the board sits on the stand as before.
2026-10-25 Ignore KiCad plot output and backups
2026-10-25 Add TP1-TP2 jumper pads for a D5 to TLV MCLK wire
    Two 3.8 x 2.0 mm SMD pads: TP1 on Feather D5, TP2 on TLV320 MCLK, with
    silkscreen and a schematic note. A 15 MHz PWM clock on D5 lets the TLV
    PLL lock; running it from BCLK sounds muffled. DRC: no new errors.
2026-10-25 Add a CircuitPython FLAC player example
    firmware/code.py plays a folder of FLACs from the microSD card with MCLK
    on D5, a 100 ms buffer, and the I2S buffers reserved before the decoder
    loads. README now says FLAC instead of MP3 and points to the firmware.
2026-10-26 Add breadboard wiring diagram to the site
    Shows the same circuit wired by hand on a full-size breadboard (22
    jumpers), to contrast with the landing pad.
2026-10-26 README: add the breadboard wiring diagram
2026-10-26 firmware: NeoKey 1x4 and ANO player controls
    lib/chordkeys.py reads the NeoKey and the ANO as Grippy-style chords
    (menu and alpha layers). code.py uses the ANO for volume, track skip and
    pause/resume, and still plays when the keys are not plugged in.
2026-10-26 Add build video links to the site
    Stills of the fabrication and assembly videos link to them on Google Drive.
2026-10-26 Simplify the site: reorder sections, drop captions and the stand section
    Build videos move under the break apart, schematic and PCB move to the
    bottom. The assembly image is dropped from the README too.
2026-10-27 firmware: menus, search, 24/96 playback and a fast e-ink driver
    - Browse with the ANO wheel, NeoKeys for play / pause / reverse / forward,
    hold 3 / 4 to rewind and fast-forward, all four keys to search by chords.
    - lib/fastscreen.py drives the SSD1680 directly with partial updates
    instead of the 5.6 s displayio 4-gray refresh.
    - 88.2 / 96 kHz TLV320 clocks, and an SRAM-first load order so 24/96
    decodes in time.
    - lib/adafruit_flac: the FLAC library build with seek().
    - Site: link the firmware.
2026-10-28 firmware: plain keys instead of chords, steadier 24/96 timing
    - lib/keys.py replaces chordkeys.py: NeoKeys play / pause / reverse /
    forward, hold 3 / 4 to scan, ANO buttons and wheel. One seesaw read per
    loop pass, the wheel every other one, so key polling costs the FLAC
    decoder less. Search mode and its index are gone.
    - Time FLACPlayer's halves from the real I2S rate. The RP2350 PIO divider
    rounds 96 kHz to 95992 Hz at 300 MHz, 80 ppm slow.
    - E-ink redraws while the wheel is still turning, not only after it stops.
    - ANO left / right page buttons flipped to suit the mounting.
    - Speaker amp off explicitly; FRISSON_PLAY in settings.toml plays a track
    at boot, for testing.
    Co-Author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
